eshazen/dosi-box-psu/README.md

# dosi-box-psu
DOSI box power supply PCB

To Do:

* Fix footprints on APD power connectors, and correct spacing if needed
