eshazen/dosi-box-psu/KiCAD/power-board/3D/ELC-10-Group.step

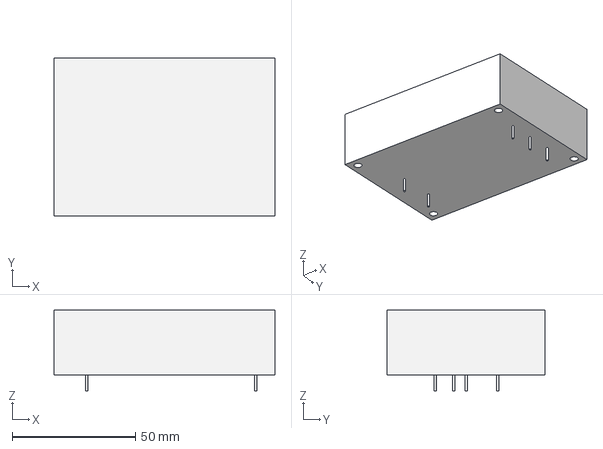
[picture p1: CAD file, 2024-01-08]
KiCAD/power-board/3D/ELC-10-Group.step
89.7 x 64.3 x 32.8 mm
