eshazen/dosi-box-psu/KiCAD/power-board/dxf/power-board-Edge_Cuts.dxf

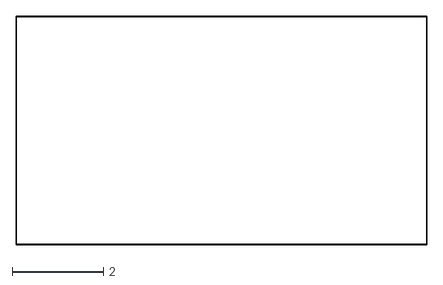
[picture p2: CAD file, 2024-01-18]
KiCAD/power-board/dxf/power-board-Edge_Cuts.dxf
9.00 x 5.00
