eshazen/dosi-box-psu/KiCAD/power-board/models/4-641126-0.step

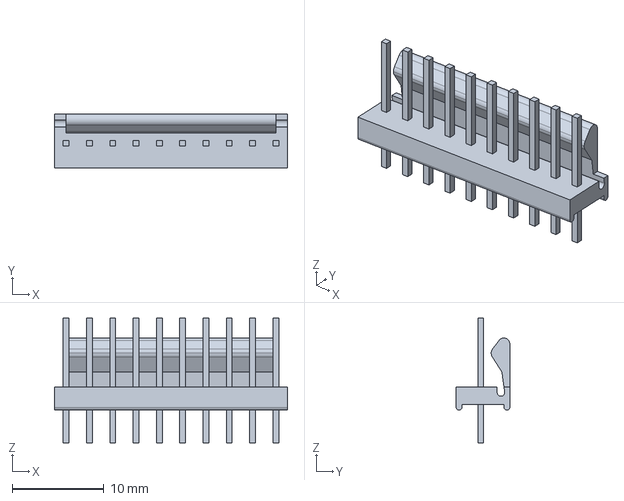
[picture p3: CAD file, 2024-01-25]
KiCAD/power-board/models/4-641126-0.step
25.4 x 5.84 x 13.6 mm
