eshazen/dosi-box-psu/KiCAD/power-board/models/SBH11-PBPC-D05-ST-BK.step

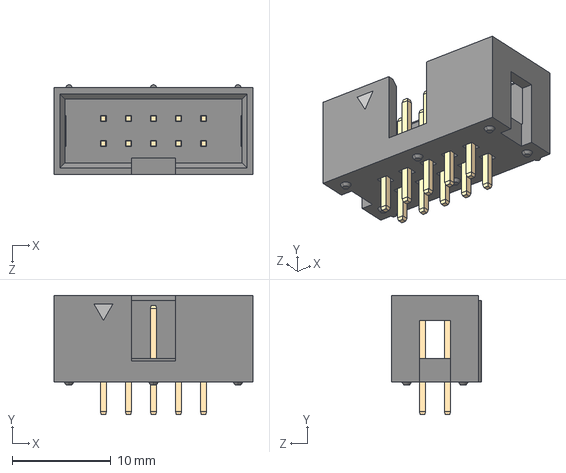
[picture p4: CAD file, 2024-01-18]
KiCAD/power-board/models/SBH11-PBPC-D05-ST-BK.step
20.2 x 12.1 x 9.09 mm
