eshazen/dosi-box-psu/KiCAD/power-board/3D/39-29-0023--3DModel-STEP-361473.STEP

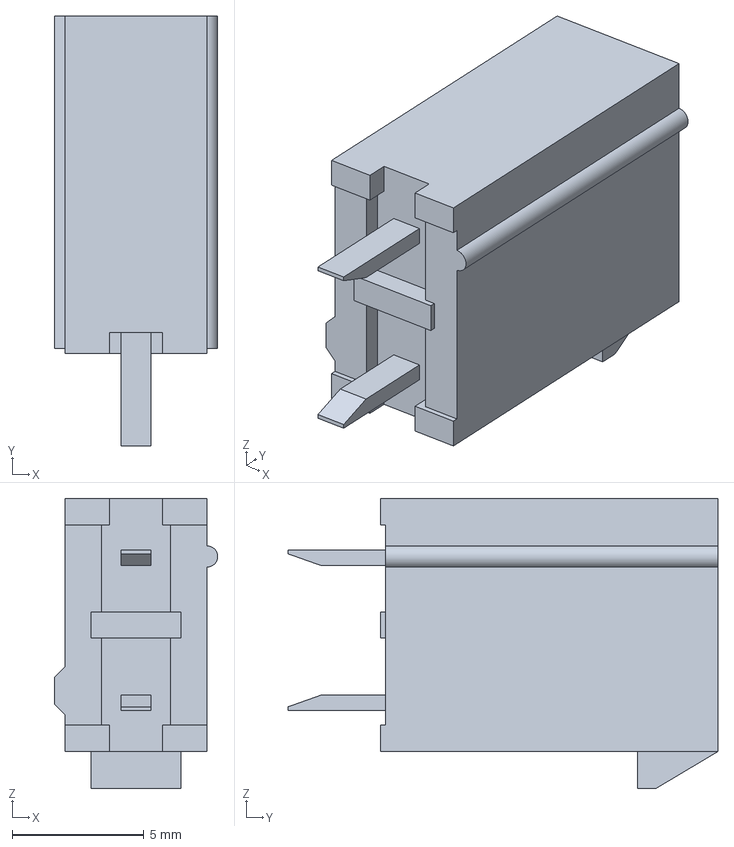
[picture p5: CAD file, 2024-01-08]
KiCAD/power-board/3D/39-29-0023--3DModel-STEP-361473.STEP
6.20 x 16.3 x 11.0 mm
