eshazen/dosi-box-psu/KiCAD/power-board/models/c-5104338-5-c-3d.stp

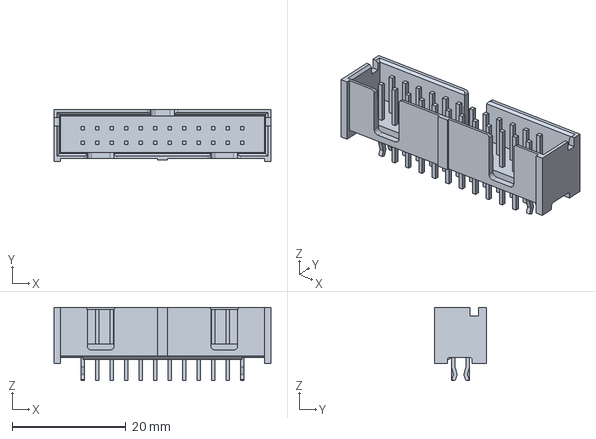
[picture p6: CAD file, 2024-01-18]
KiCAD/power-board/models/c-5104338-5-c-3d.stp
38.1 x 9.14 x 12.9 mm
