eshazen/dosi-box-psu/KiCAD/power-board/models/3-641119-4.step

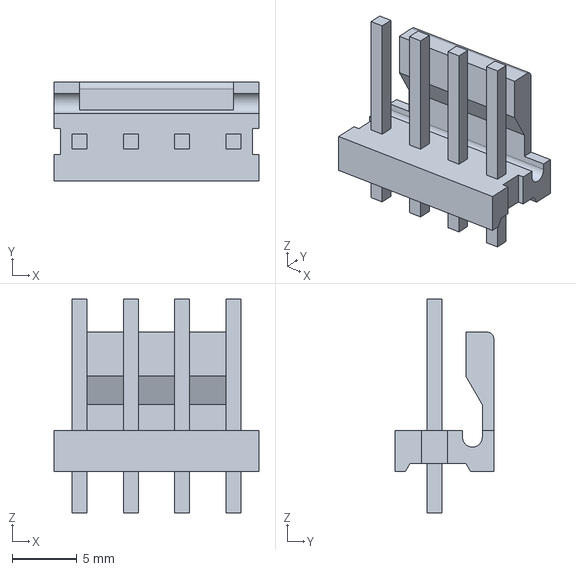
[picture p7: CAD file, 2024-01-18]
KiCAD/power-board/models/3-641119-4.step
15.8 x 7.62 x 16.5 mm
