eshazen/dosi-box-psu/KiCAD/power-board/models/3-641208-6.step

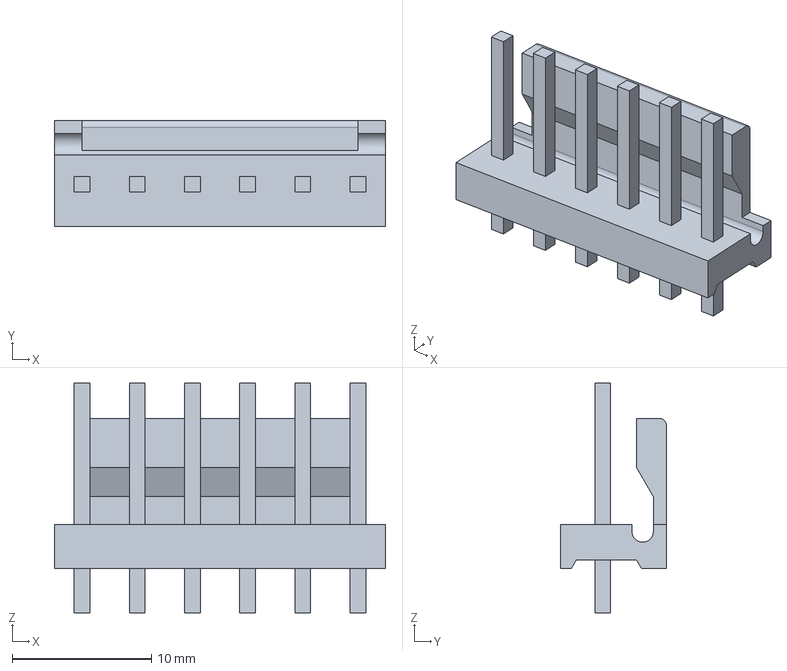
[picture p8: CAD file, 2024-01-16]
KiCAD/power-board/models/3-641208-6.step
23.8 x 7.62 x 16.5 mm
