eshazen/dosi-box-psu/KiCAD/power-board/models/TST-112-01-G-D.stp

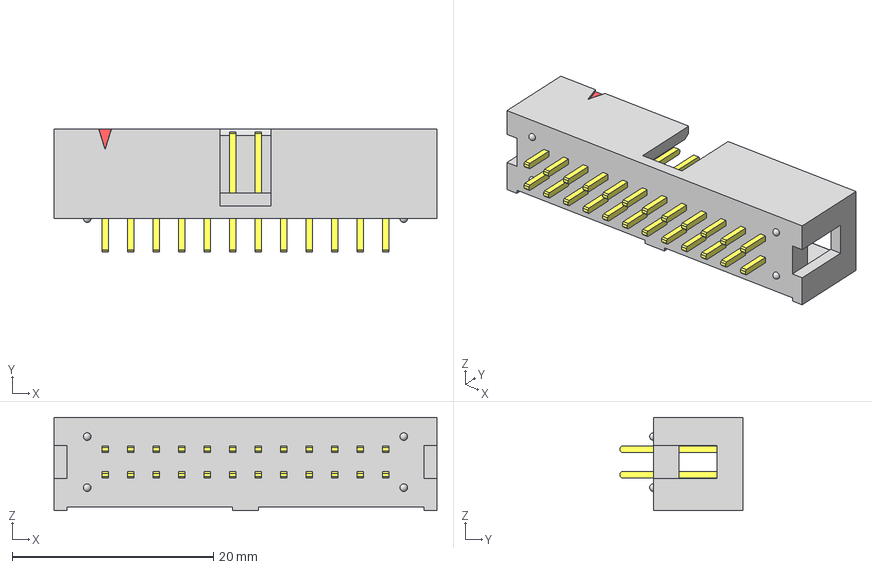
[picture p9: CAD file, 2024-01-10]
KiCAD/power-board/models/TST-112-01-G-D.stp
38.1 x 12.2 x 9.27 mm
T-1S6-12-01-D
TST-First_Position_Indicator
TST-112-01-D_header
