eshazen/dosi-box-psu/KiCAD/power-board/models/2-644486-3.stp

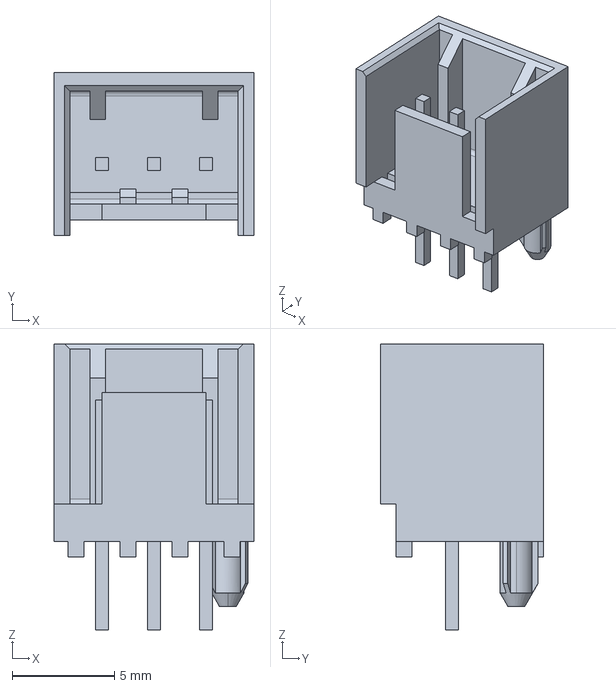
[picture p10: CAD file, 2024-01-10]
KiCAD/power-board/models/2-644486-3.stp
9.75 x 7.95 x 14.0 mm
