eshazen/dosi-box-psu/KiCAD/power-board/models/2-644803-3.step

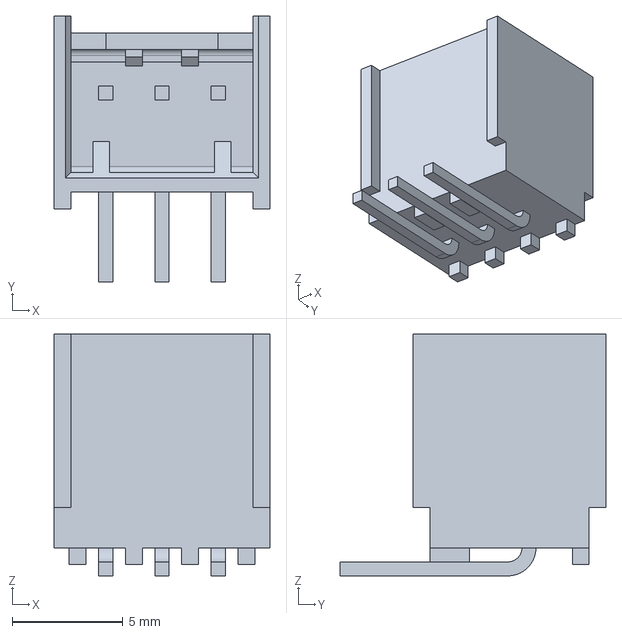
[picture p11: CAD file, 2024-01-10]
KiCAD/power-board/models/2-644803-3.step
9.75 x 12.0 x 10.9 mm
