eshazen/dosi-box-psu/KiCAD/power-board/models/KPJX-4S-S.step

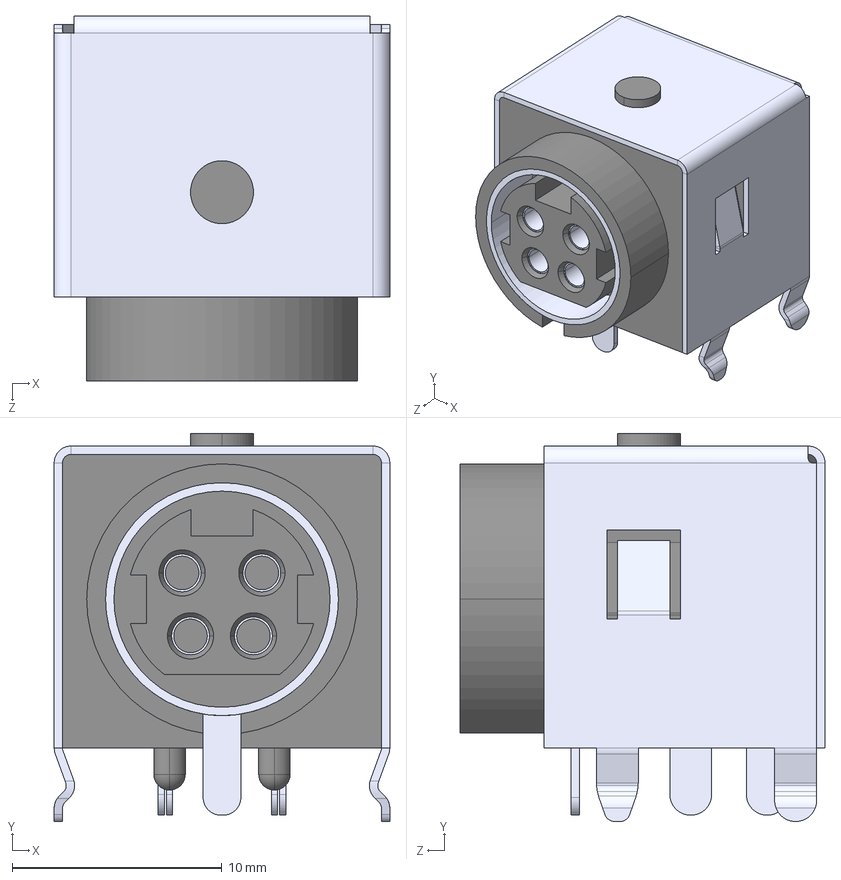
[picture p12: CAD file, 2024-01-08]
KiCAD/power-board/models/KPJX-4S-S.step
16.0 x 18.5 x 17.4 mm
