eshazen/dosi-box-psu/KiCAD/power-board/models/39-29-0043--3DModel-STEP-361473.STEP

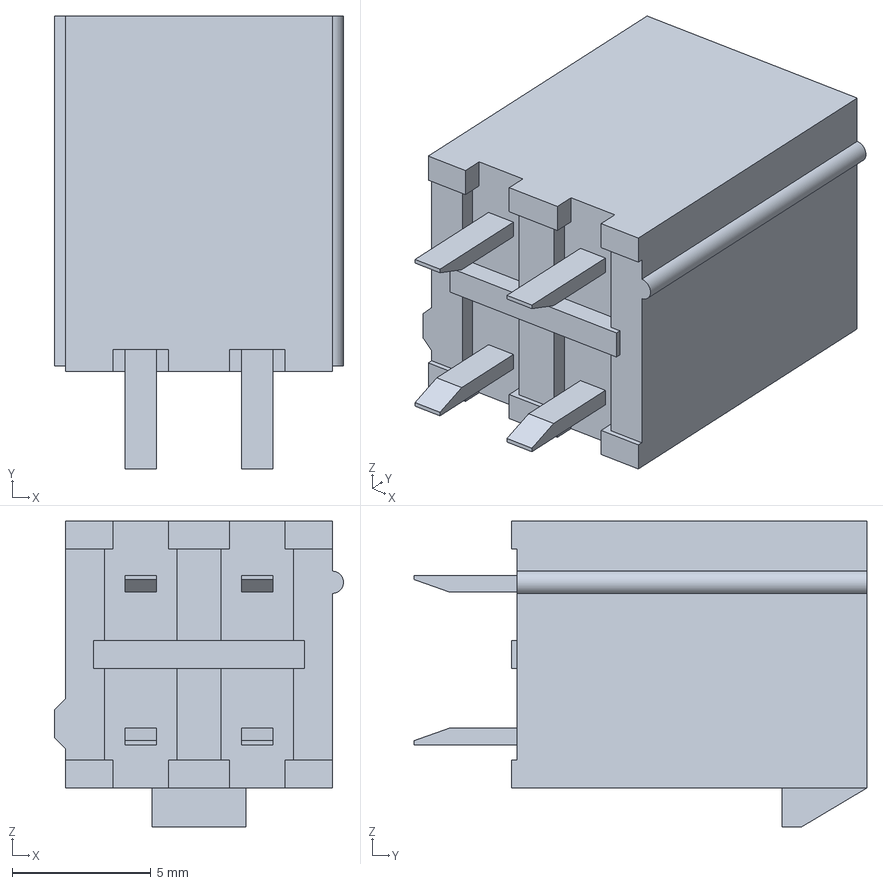
[picture p13: CAD file, 2024-01-08]
KiCAD/power-board/models/39-29-0043--3DModel-STEP-361473.STEP
10.4 x 16.3 x 11.0 mm
