eshazen/dosi-box-psu/KiCAD/power-board/models/644752-2.step

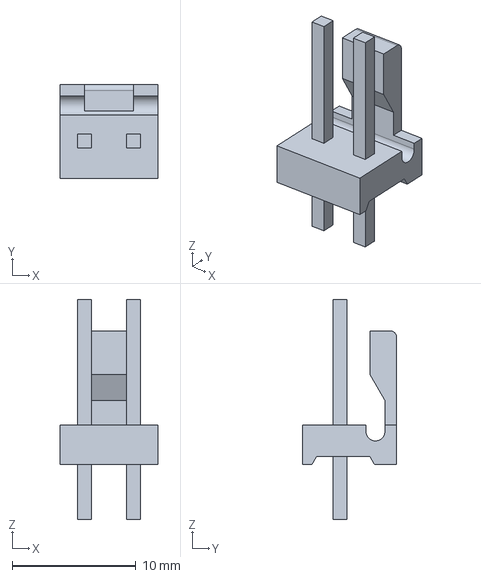
[picture p14: CAD file, 2024-01-10]
KiCAD/power-board/models/644752-2.step
7.92 x 7.62 x 17.8 mm
