eshazen/dosi-box-psu/KiCAD/power-board/models/705530002.stp

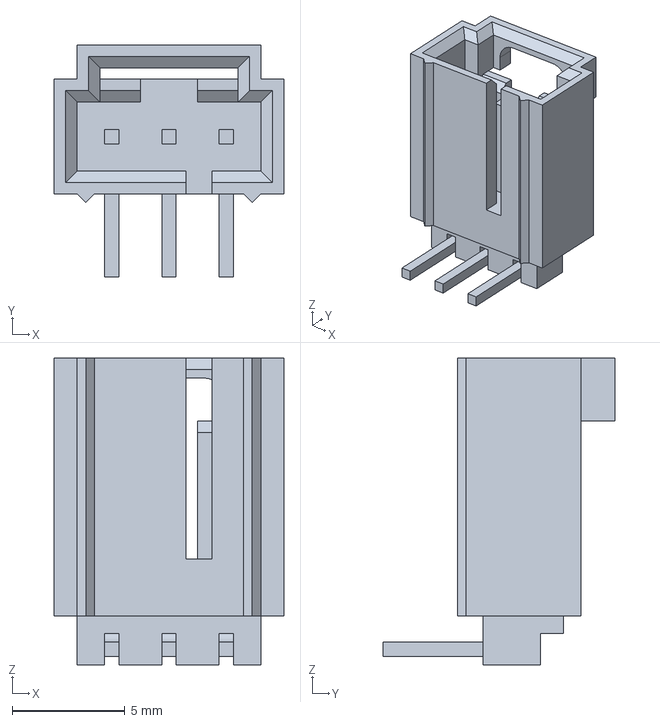
[picture p15: CAD file, 2024-01-08]
KiCAD/power-board/models/705530002.stp
10.2 x 10.3 x 13.6 mm
