eshazen/dosi-box-psu/KiCAD/power-board/models/1722982206.step

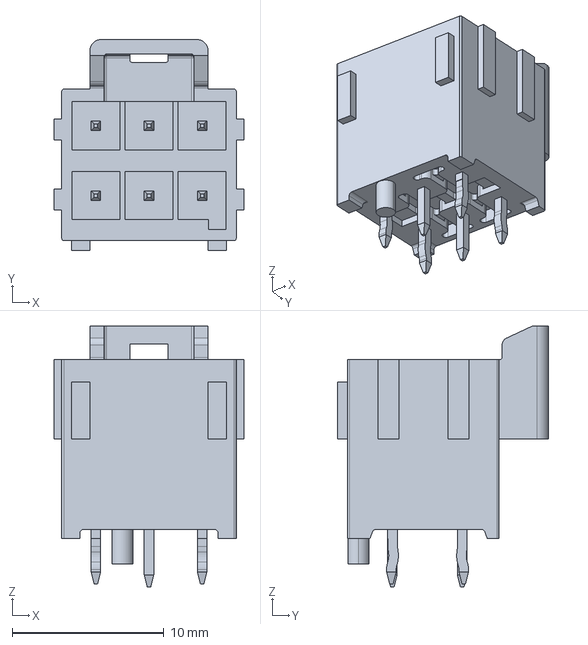
[picture p16: CAD file, 2024-01-08]
KiCAD/power-board/models/1722982206.step
12.5 x 13.9 x 17.2 mm
