eshazen/dosi-box-psu/(list of files, cad)

Other CAD files:
KiCAD/power-board/3D/ELC-10.stl
KiCAD/power-board/dxf/power-board-F_Mask.dxf
