eshazen/dosi-box-psu/KiCAD/power-board/power-board.pdf

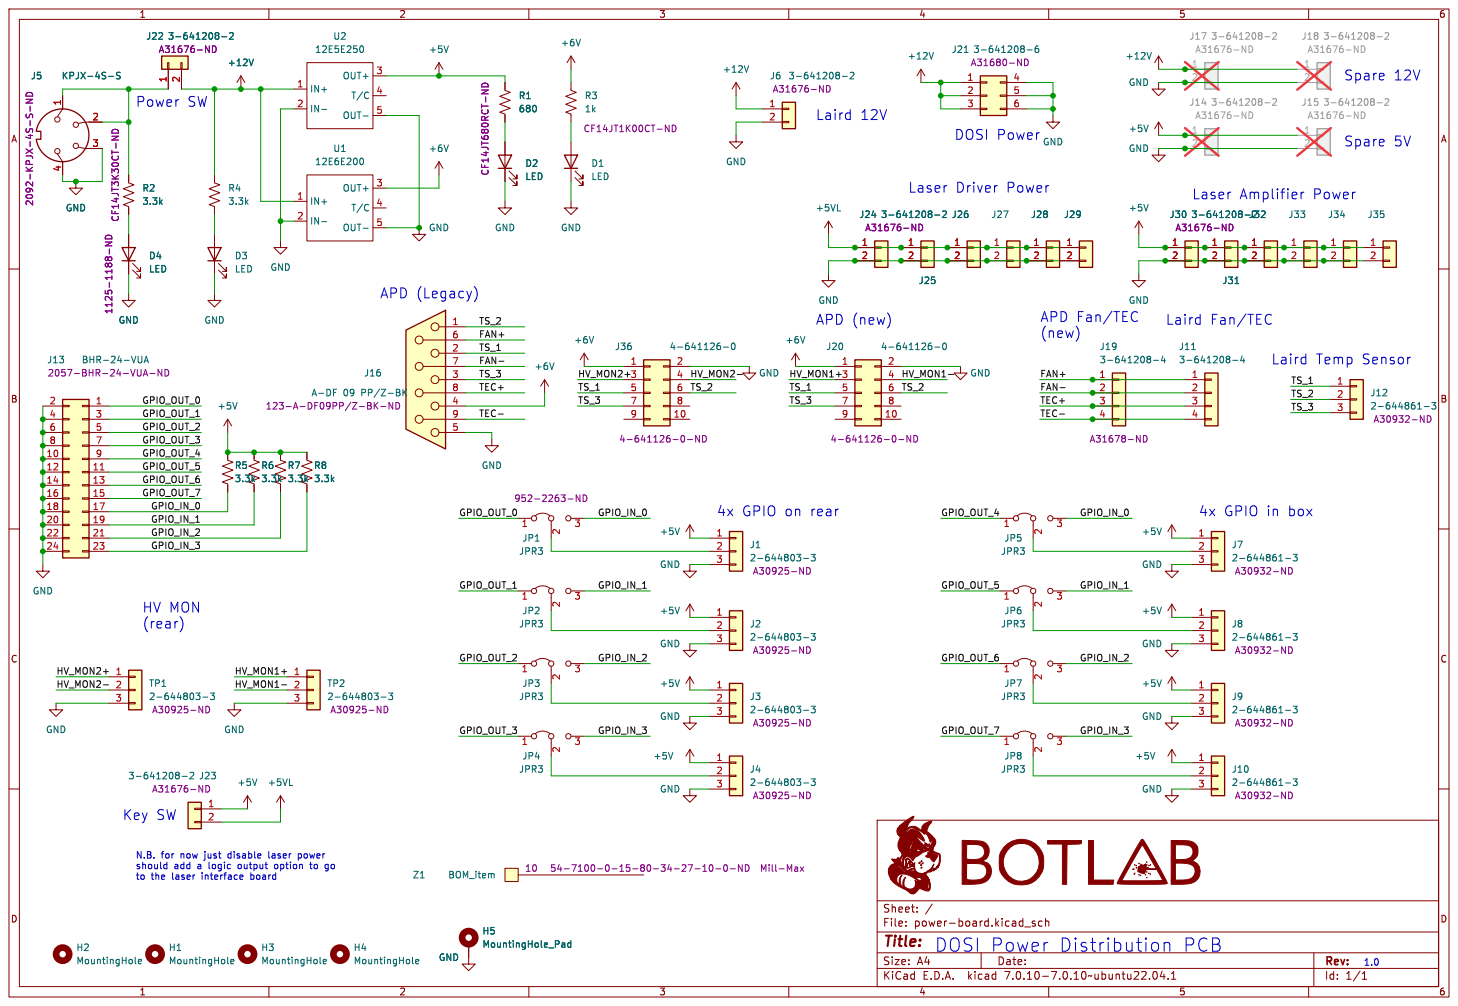
[picture p17: page 1]

N.B. for now just disable laser power should add a logic output option to go

Id: 1/1 Title: File: power-board.kicad_sch Sheet: / GND
