eshazen/dosi-box-psu/(commit log)

2024-01-08 Starting on power PCB
    [1722982206.step, 39-29-0023--3DModel-STEP-361473.STEP, 39-29-0043--3DModel-STEP-361473.STEP, 39290023.step, 39290043.step, 705530002.stp, ELC-10-Group.step, ELC-10.scad]
2024-01-10 working on layout, placement maybe complete
    [2-644486-3.stp, 2-644803-3.step, 644752-2.step, TST-112-01-G-D.stp, power-board-Edge_Cuts.dxf, power-board-F_Mask.dxf, power-board.kicad_pcb, power-board.kicad_sch]
2024-01-16 Candidate power board
    [3-641208-6.step, power-board.kicad_pcb, power-board.kicad_sch]
2024-01-18 add laird and APD stuff
    [3-641119-4.step, power-board-Edge_Cuts.dxf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]
2024-01-18 candidate Rev 1.0
    [SBH11-PBPC-D05-ST-BK.step, c-5104338-5-c-3d.stp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]
2024-01-18 schematic pdf
2024-01-23 update footprints and part numbers
    [power-board.kicad_pcb, power-board.kicad_sch]
2024-01-25 2nd APD
    [4-641126-0.step, power-board.kicad_pcb, power-board.kicad_sch]
2024-01-25 V1.0 as built
    [power-board-B_Cu.gbr, power-board-B_Mask.gbr, power-board-B_Paste.gbr, power-board-Edge_Cuts.gbr, power-board-F_Cu.gbr, power-board-F_Mask.gbr, power-board-F_Paste.gbr, power-board-F_Silkscreen.gbr]
2024-01-29 Update APD connectors, finally ready for fab
    [power-board-B_Cu.gbr, power-board-B_Mask.gbr, power-board-B_Paste.gbr, power-board-B_Silkscreen.gbr, power-board-Edge_Cuts.gbr, power-board-F_Cu.gbr, power-board-F_Mask.gbr, power-board-F_Paste.gbr]
2024-02-06 Rev 1.1 changes: footprints, add GND hole
    [power-board.kicad_pcb, power-board.kicad_sch]
2024-02-07 Update MTA-156 2 pin to straight, bom, pdf
    [power-board.csv, power-board.kicad_sch]
