eshazen/dosi-box-psu/(notices)

Notices in the files:
KiCAD/power-board/models/TST-112-01-G-D.stp:
author */ ('License CC BY-ND 4.0'),
